Awat21/Willie_Finder/README.md

# Willie_Finder
Cat tracker using LORA

- [BOM.md](BOM.md) - parts list with links
- [case/](case/) - collar pod case model (STEP, STL, CadQuery source)
- [pcb/](pcb/) - custom single-board tracker: schematic and first-pass layout (KiCad 9)
