Awat21/Willie_Finder/pcb/renders/board_bottom.png

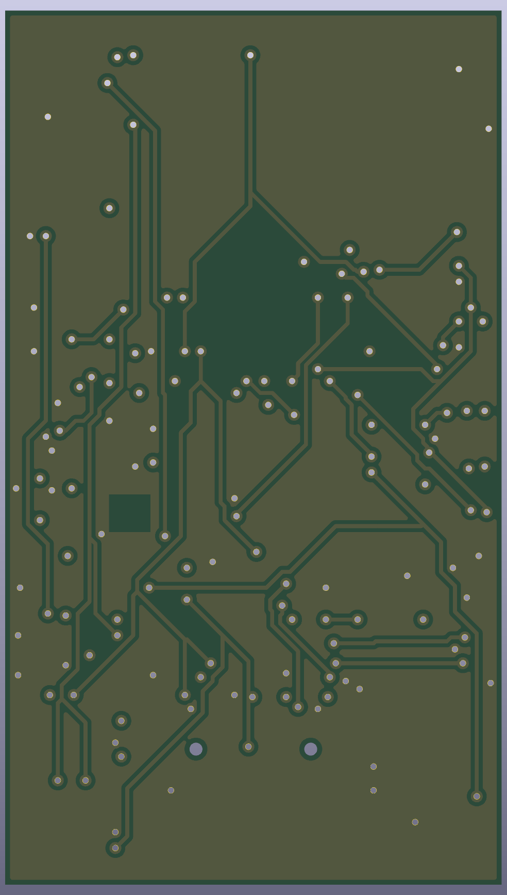
pcb/renders/board_bottom.png
