Awat21/Willie_Finder/pcb/renders/board_top.png

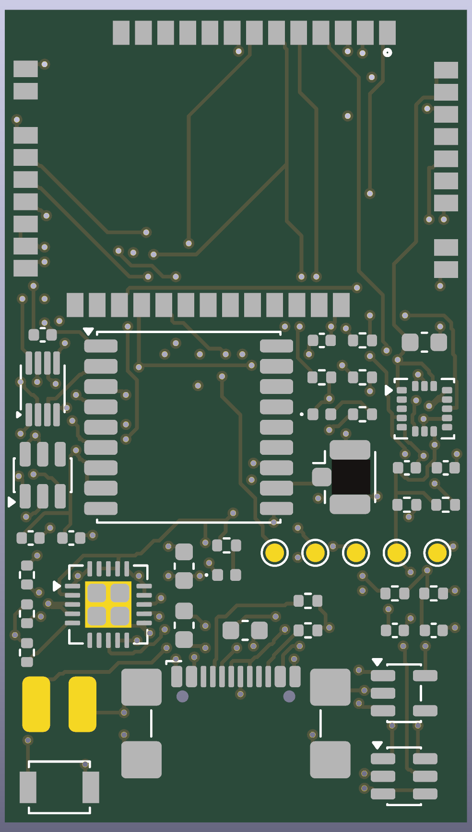
pcb/renders/board_top.png
