Awat21/Willie_Finder/case/collar_pod_case.step

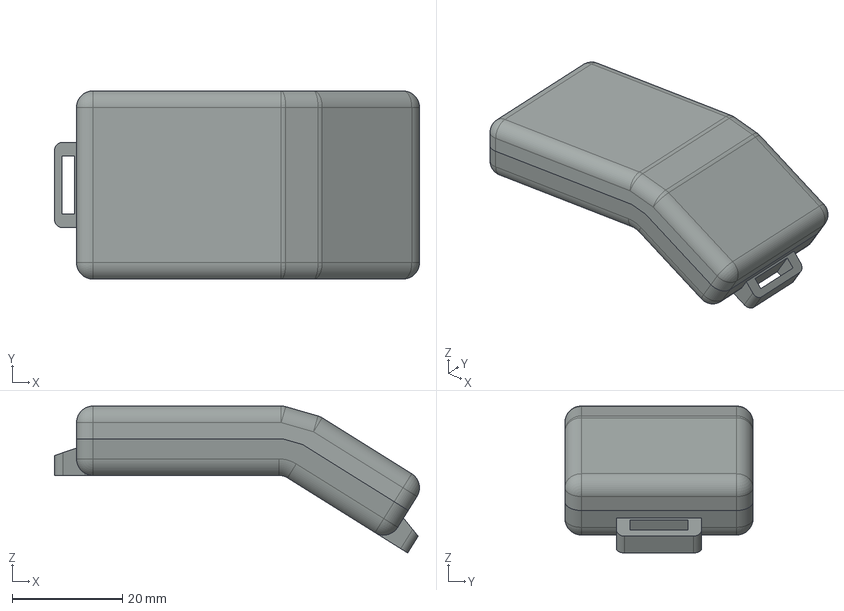
[picture p3: CAD file, 2026-11-11]
case/collar_pod_case.step
66.3 x 34.2 x 26.7 mm
base
lid
