Awat21/Willie_Finder/case/stl/base.stl

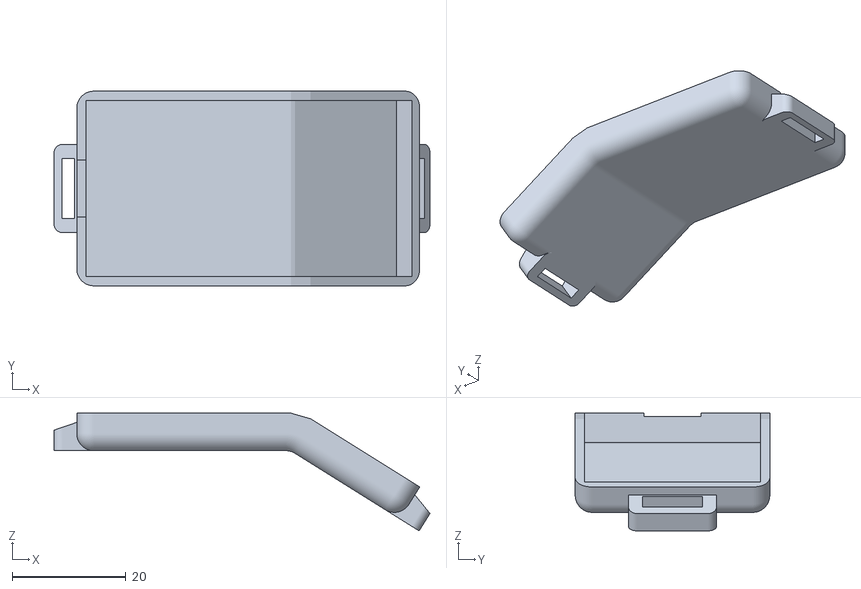
[picture p4: CAD file, 2026-11-11]
case/stl/base.stl
66.1 x 34.2 x 20.7
