Awat21/Willie_Finder/pcb/willie_tracker_board.step

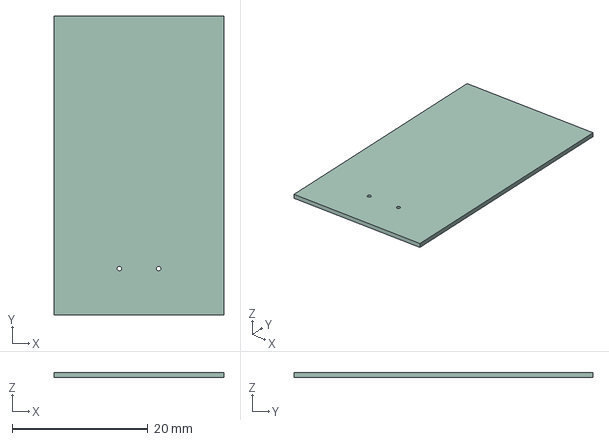
[picture p5: CAD file, 2026-11-11]
pcb/willie_tracker_board.step
25.0 x 44.0 x 0.71 mm
