Awat21/Willie_Finder/case/collar_pod.step

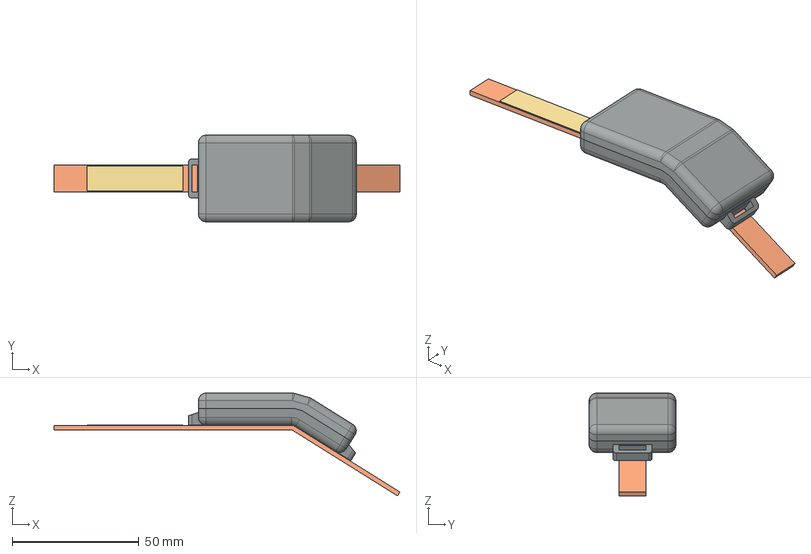
[picture p6: CAD file, 2026-11-11]
case/collar_pod.step
136.6 x 34.2 x 40.6 mm
base
lid
board
battery
gps
strap
antenna
