Awat21/Willie_Finder/case/stl/lid.stl

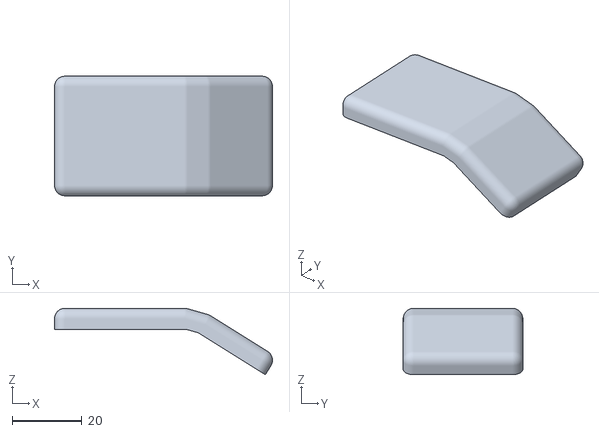
[picture p7: CAD file, 2026-11-11]
case/stl/lid.stl
62.3 x 34.2 x 19.0
