Awat21/Willie_Finder/case/stl/strap.stl

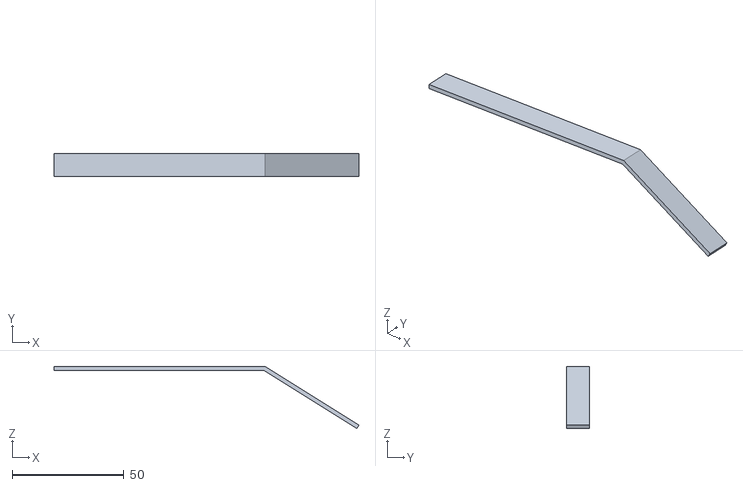
[picture p8: CAD file, 2026-11-11]
case/stl/strap.stl
136.6 x 10.5 x 27.8
