Awat21/Willie_Finder/case/stl/gps.stl

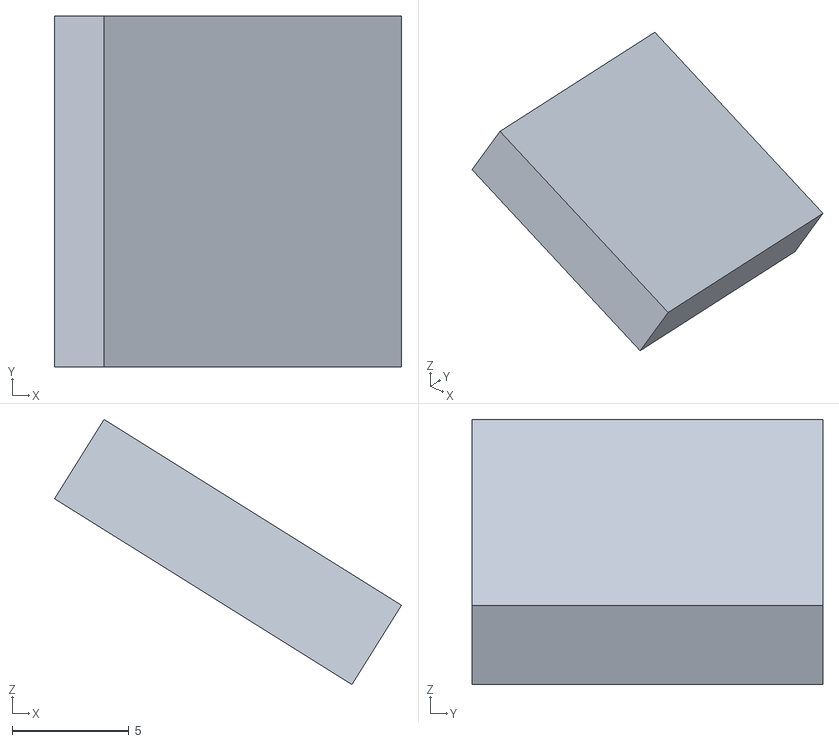
[picture p9: CAD file, 2026-11-11]
case/stl/gps.stl
14.8 x 15.0 x 11.3
