Awat21/Willie_Finder/case/stl/battery.stl

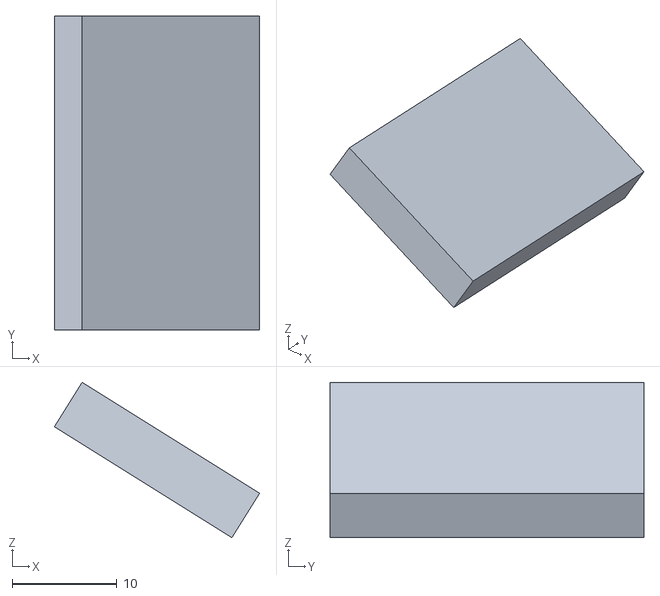
[picture p10: CAD file, 2026-11-11]
case/stl/battery.stl
19.6 x 30.0 x 14.8
