Awat21/Willie_Finder/case/stl/antenna.stl

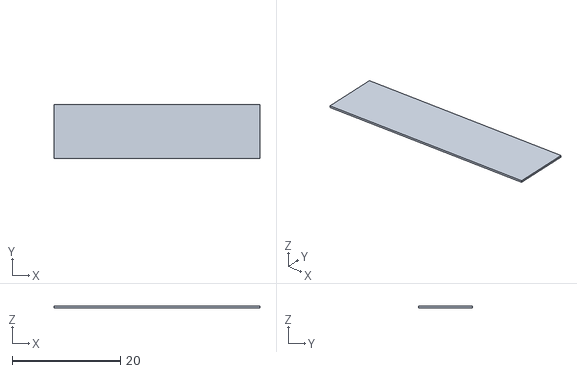
[picture p11: CAD file, 2026-11-11]
case/stl/antenna.stl
38.0 x 10.0 x 0.3
