Awat21/Willie_Finder/case/stl/board.stl

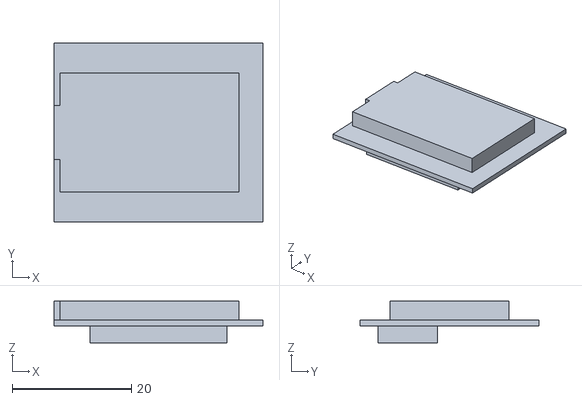
[picture p12: CAD file, 2026-11-11]
case/stl/board.stl
35.0 x 30.0 x 7.00
