Awat21/Willie_Finder/pcb/willie_tracker.pdf

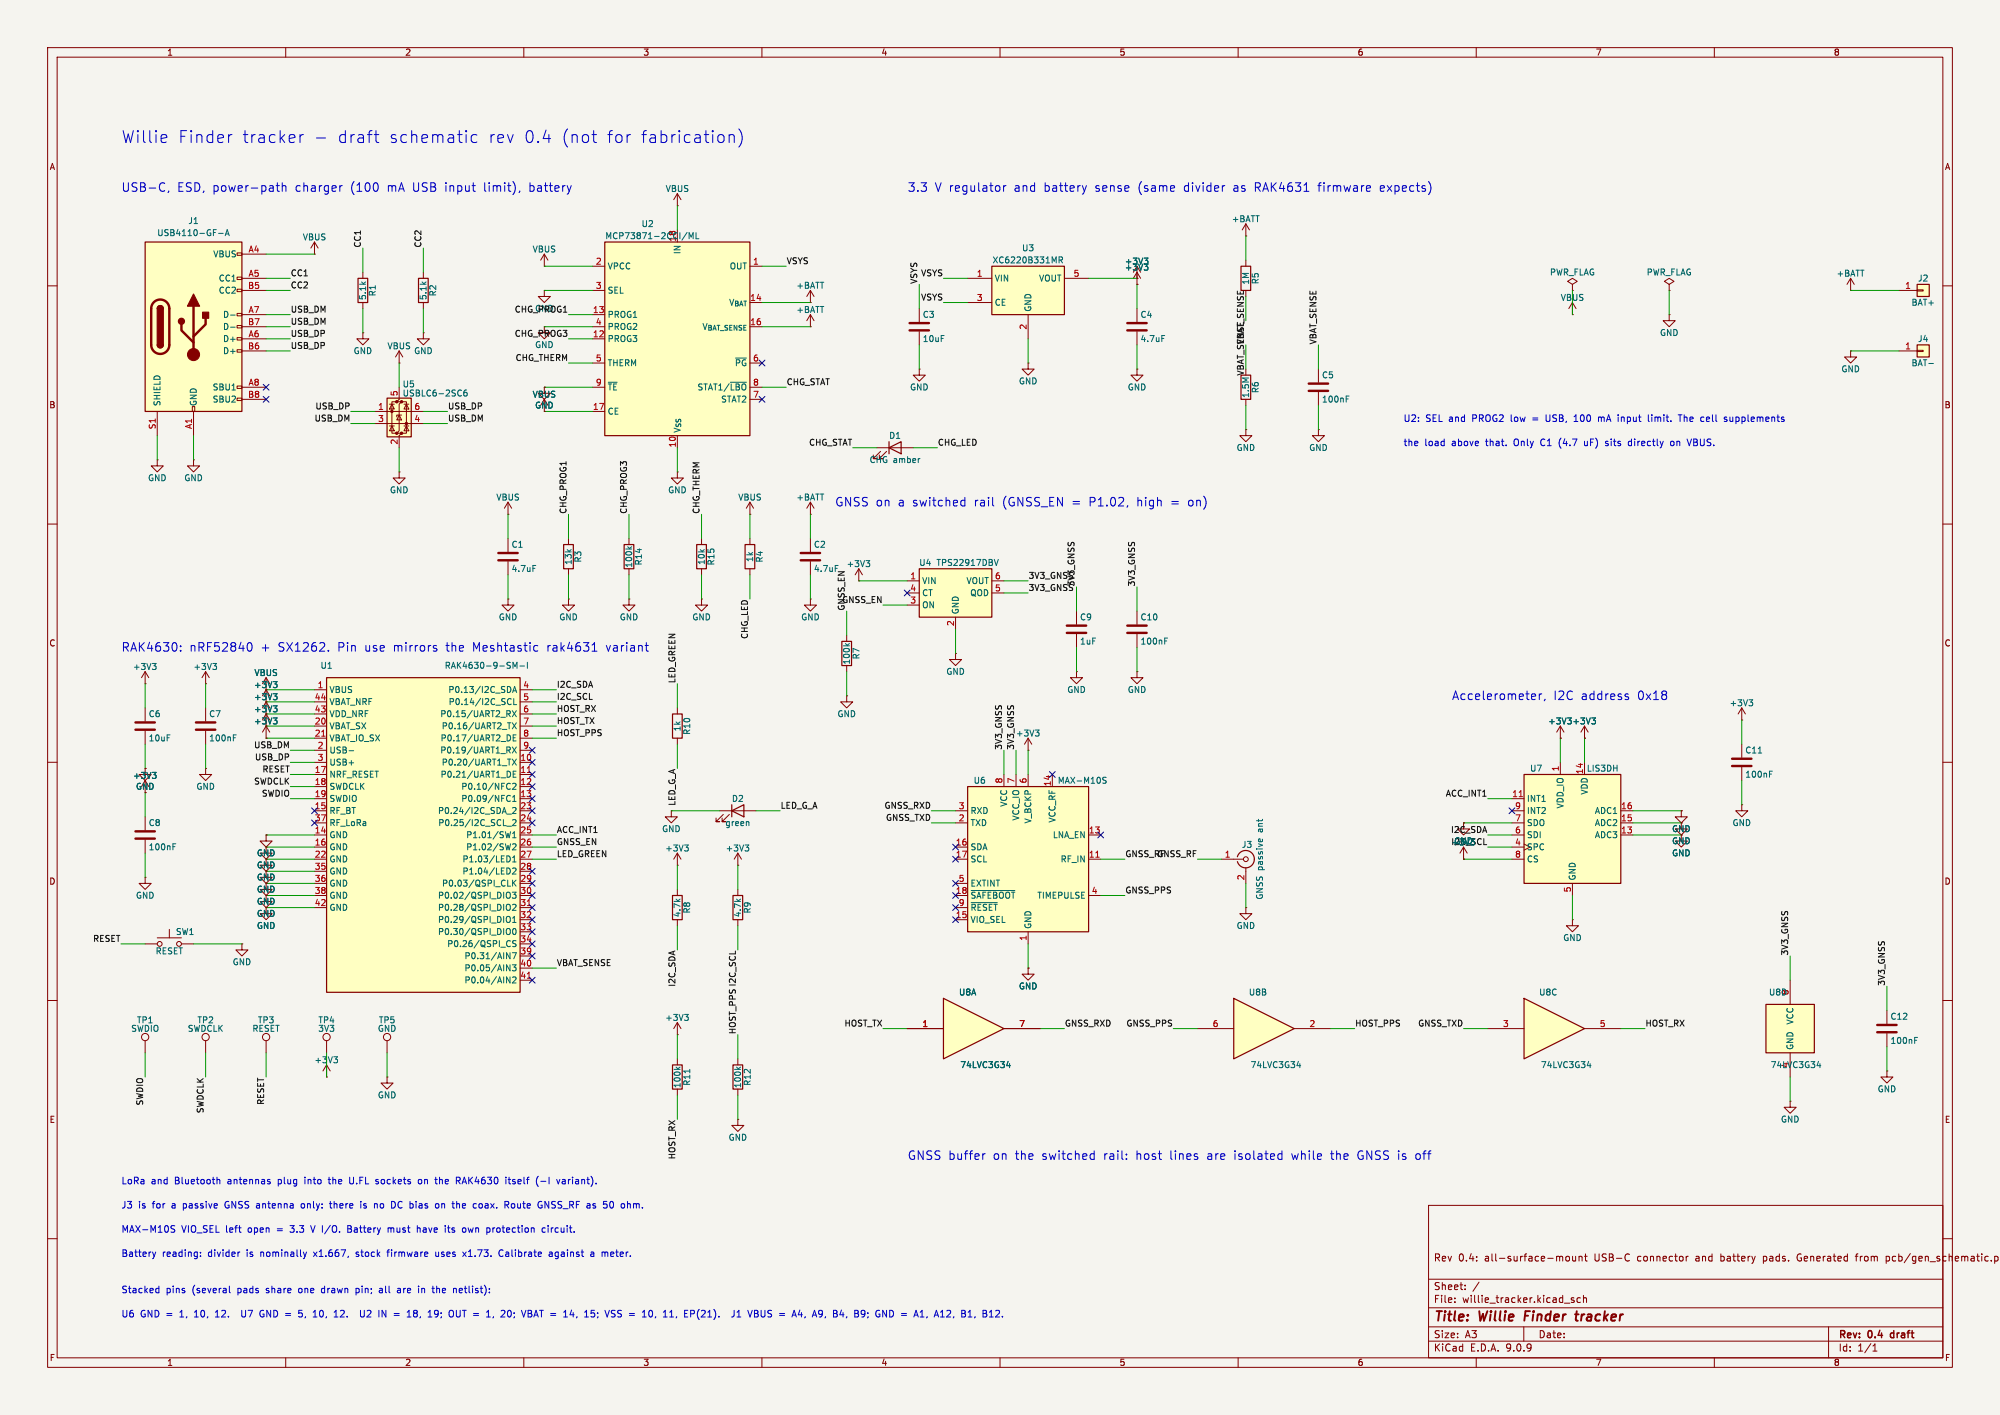
[picture p13: page 1]

I2C_SDA U2: SEL and PROG2 low = USB, 100 mA input limit. The cell supplements
