Awat21/Willie_Finder/pcb/willie_tracker.kicad_pcb

## KiCad design pcb/willie_tracker.kicad_pcb (2026-11-11)

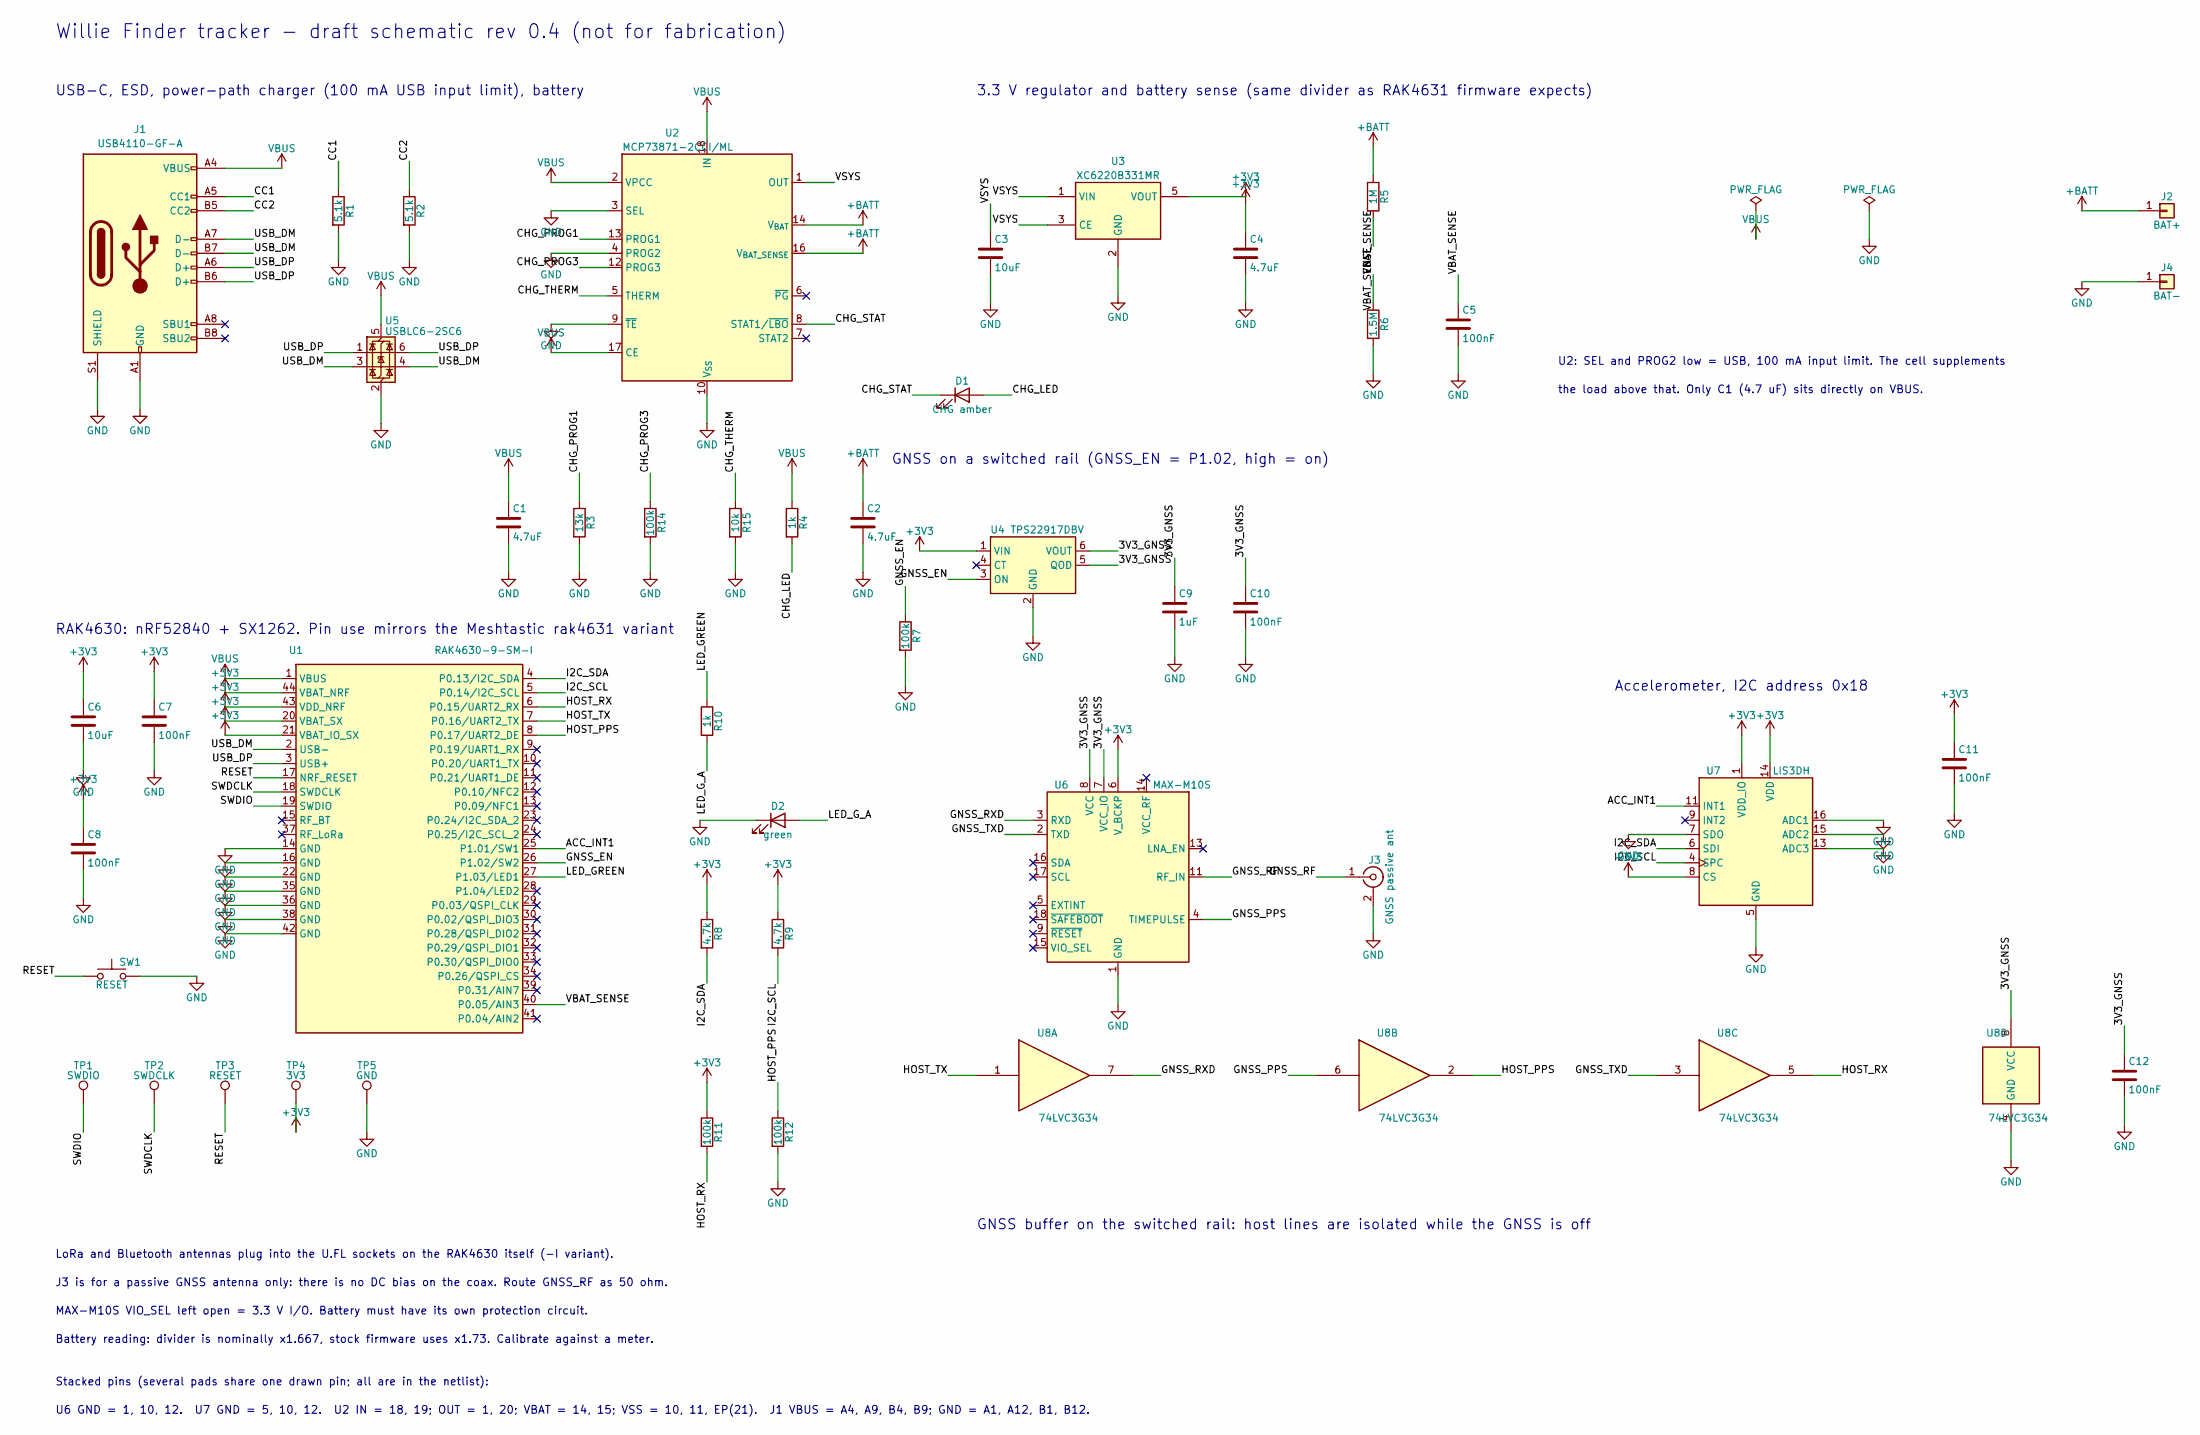
[picture p14: schematic willie_tracker.kicad_sch, Willie Finder tracker]

Parts:
C1, C2: 4.7uF; C_0603_1608Metric
C3, C6: 10uF; C_0603_1608Metric
C4: 4.7uF; C_0402_1005Metric
C5, C7, C8, C10, C11, C12: 100nF; C_0402_1005Metric
C9: 1uF; C_0402_1005Metric
D1: CHG amber; LED_0402_1005Metric
D2: green; LED_0402_1005Metric
J1: USB4110-GF-A; USB_C_Receptacle_GCT_USB4110
J2: BAT+; SolderWirePad_1x01_SMD_1.5x3mm
J3: GNSS passive ant; U.FL_Hirose_U.FL-R-SMT-1_Vertical
J4: BAT-; SolderWirePad_1x01_SMD_1.5x3mm
R1, R2: 5.1k; R_0402_1005Metric
R3: 13k; R_0402_1005Metric
R4, R10: 1k; R_0402_1005Metric
R5: 1M; R_0402_1005Metric
R6: 1.5M; R_0402_1005Metric
R7, R11, R12, R14: 100k; R_0402_1005Metric
R8, R9: 4.7k; R_0402_1005Metric
R15: 10k; R_0402_1005Metric
SW1: RESET; SW_SPST_B3U-1000P
TP1: SWDIO; TestPoint_Pad_D1.0mm
TP2: SWDCLK; TestPoint_Pad_D1.0mm
TP3: RESET; TestPoint_Pad_D1.0mm
TP4: 3V3; TestPoint_Pad_D1.0mm
TP5: GND; TestPoint_Pad_D1.0mm
U1: RAK4630-9-SM-I; RAK4630
U2: MCP73871-2CCI/ML; QFN-20-1EP_4x4mm_P0.5mm_EP2.5x2.5mm
U3: XC6220B331MR; SOT-23-5
U4: TPS22917DBV; SOT-23-6
U5: USBLC6-2SC6; SOT-23-6
U6: MAX-M10S; ublox_MAX
U7: LIS3DH; LGA-16_3x3mm_P0.5mm_LayoutBorder3x5y
U8: 74LVC3G34; VSSOP-8_2.3x2mm_P0.5mm

Connections:
+3V3: C4.1, C6.1, C7.1, C8.1, C11.1, R8.1, R9.1, R11.1, TP4.1, U1.20 (VBAT_SX), U1.21 (VBAT_IO_SX), U1.43 (VDD_NRF), U1.44 (VBAT_NRF), U3.5 (VOUT), U4.1 (VIN), U6.6 (V_BCKP), U7.1 (VDD_IO), U7.8 (CS), U7.14 (VDD)
+BATT: C2.1, J2.1, R5.1, U2.14 (V_{BAT}), U2.15 (V_{BAT}), U2.16 (V_{BAT_SENSE})
/3V3_GNSS: C9.1, C10.1, C12.1, U4.5 (QOD), U4.6 (VOUT), U6.7 (VCC_IO), U6.8 (VCC), U8.8 (VCC)
/ACC_INT1: U1.25 (P1.01/SW1), U7.11 (INT1)
/CC1: J1.A5 (CC1), R1.1
/CC2: J1.B5 (CC2), R2.1
/CHG_LED: D1.2 (A), R4.2
/CHG_PROG1: R3.1, U2.13 (PROG1)
/CHG_PROG3: R14.1, U2.12 (PROG3)
/CHG_STAT: D1.1 (K), U2.8 (STAT1/~LBO)
/CHG_THERM: R15.1, U2.5 (THERM)
/GNSS_EN: R7.1, U1.26 (P1.02/SW2), U4.3 (ON)
/GNSS_PPS: U6.4 (TIMEPULSE), U8.6
/GNSS_RF: J3.1 (In), U6.11 (RF_IN)
/GNSS_RXD: U6.3 (RXD), U8.7
/GNSS_TXD: U6.2 (TXD), U8.3
/HOST_PPS: R12.1, U1.8 (P0.17/UART2_DE), U8.2
/HOST_RX: R11.2, U1.6 (P0.15/UART2_RX), U8.5
/HOST_TX: U1.7 (P0.16/UART2_TX), U8.1
/I2C_SCL: R9.2, U1.5 (P0.14/I2C_SCL), U7.4 (SPC)
/I2C_SDA: R8.2, U1.4 (P0.13/I2C_SDA), U7.6 (SDI)
/LED_GREEN: R10.1, U1.27 (P1.03/LED1)
/LED_G_A: D2.2 (A), R10.2
/RESET: SW1.1, TP3.1, U1.17 (NRF_RESET)
/SWDCLK: TP2.1, U1.18 (SWDCLK)
/SWDIO: TP1.1, U1.19 (SWDIO)
/USB_DM: J1.A7 (D-), J1.B7 (D-), U1.2 (USB-), U5.3 (I/O2), U5.4 (I/O2)
/USB_DP: J1.A6 (D+), J1.B6 (D+), U1.3 (USB+), U5.1 (I/O1), U5.6 (I/O1)
/VBAT_SENSE: C5.1, R5.2, R6.1, U1.40 (P0.05/AIN3)
/VSYS: C3.1, U2.1 (OUT), U2.20 (OUT), U3.1 (VIN), U3.3 (CE)
GND: C1.2, C2.2, C3.2, C4.2, C5.2, C6.2, C7.2, C8.2, C9.2, C10.2, C11.2, C12.2, D2.1 (K), J1.A1 (GND), J1.A12 (GND), J1.B1 (GND), J1.B12 (GND), J1.S1 (SHIELD), J3.2 (Ext), J4.1, R1.2, R2.2, R3.2, R6.2, R7.2, R12.2, R14.2, R15.2, SW1.2, TP5.1, U1.14 (GND), U1.16 (GND), U1.22 (GND), U1.35 (GND), U1.36 (GND), U1.38 (GND), U1.42 (GND), U2.3 (SEL), U2.4 (PROG2), U2.9 (~TE), U2.10 (V_{SS}), U2.11 (V_{SS}), U2.21 (V_{SS}), U3.2 (GND), U4.2 (GND), U5.2 (GND), U6.1 (GND), U6.10 (GND), U6.12 (GND), U7.5 (GND), U7.7 (SDO), U7.10 (GND), U7.12 (GND), U7.13 (ADC3), U7.15 (ADC2), U7.16 (ADC1), U8.4 (GND)
VBUS: C1.1, J1.A4 (VBUS), J1.A9 (VBUS), J1.B4 (VBUS), J1.B9 (VBUS), R4.1, U1.1 (VBUS), U2.2 (VPCC), U2.17 (CE), U2.18 (IN), U2.19 (IN), U5.5 (VBUS)

Notes on the sheet:
Willie Finder tracker - draft schematic rev 0.4 (not for fabrication)
USB-C, ESD, power-path charger (100 mA USB input limit), battery
3.3 V regulator and battery sense (same divider as RAK4631 firmware expects)
RAK4630: nRF52840 + SX1262. Pin use mirrors the Meshtastic rak4631 variant
GNSS on a switched rail (GNSS_EN = P1.02, high = on)
Accelerometer, I2C address 0x18
GNSS buffer on the switched rail: host lines are isolated while the GNSS is off
LoRa and Bluetooth antennas plug into the U.FL sockets on the RAK4630 itself (-I variant).
J3 is for a passive GNSS antenna only: there is no DC bias on the coax. Route GNSS_RF as 50 ohm.
MAX-M10S VIO_SEL left open = 3.3 V I/O. Battery must have its own protection circuit.
Battery reading: divider is nominally x1.667, stock firmware uses x1.73. Calibrate against a meter.
Stacked pins (several pads share one drawn pin; all are in the netlist):
U6 GND = 1, 10, 12. U7 GND = 5, 10, 12. U2 IN = 18, 19; OUT = 1, 20; VBAT = 14, 15; VSS = 10, 11, EP(21). J1 VBUS = A4, A9, B4, B9; GND = A1, A12, B1, B12.
U2: SEL and PROG2 low = USB, 100 mA input limit. The cell supplements
the load above that. Only C1 (4.7 uF) sits directly on VBUS.

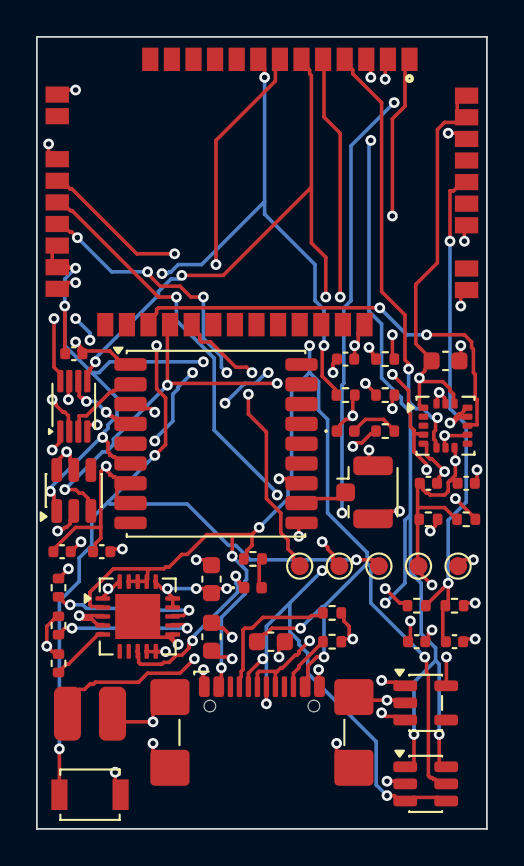
[picture p15: board willie_tracker.kicad_pcb from above]

Board: 4 copper layers, 25.0 x 44.0 mm, 46 parts (0 on the bottom side), 32 nets.
