Awat21/Willie_Finder/(commit log)

2026-11-11 Add collar pod case form-factor study
    Parametric OpenSCAD model and exported STLs for a low-profile, two-bay
    collar pod sized for the RAK WisBlock tracker parts.
    Claude-Session: https://claude.ai/code/session_015rZZoadH2C2otnBPXLuQXJ
    [base.stl, battery.stl, board.stl, collar_pod.scad, gps.stl, lid.stl, strap.stl]
2026-11-11 Show adhesive flex LoRa antenna on the collar in the case model
    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
    [antenna.stl, collar_pod.scad, strap.stl]
2026-11-11 Add BOM and STEP export of the collar pod case
    Rebuild the case in CadQuery so it exports true solid STEP files for
    editing in CAD, replacing the OpenSCAD source. Add a linked parts list.
    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
    [antenna.stl, base.stl, battery.stl, board.stl, collar_pod.scad, collar_pod.step, collar_pod_case.step, gps.stl]
2026-11-11 Add first-pass KiCad schematic for a custom tracker PCB
    Generated from a parts/net table; connectivity is checked by exporting
    the netlist with kicad-cli and comparing it to the table.
    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
    [willie_tracker.kicad_sch]
2026-11-11 Apply schematic review findings (rev 0.2)
    Add USB load sharing, use the recommended regulator capacitors, buffer
    the GNSS UART and PPS lines from the switched rail, and document the
    passive antenna and firmware checks.
    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
    [willie_tracker.kicad_sch]
2026-11-11 Schematic rev 0.3: power-path charger and verified stacked pads
    Replace the MCP73831 and discrete load sharing with an MCP73871 set to
    the 100 mA USB input limit. Export the KiCad netlist into the repo and
    assert the stacked ground and supply pads on every check run.
    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
    [willie_tracker.kicad_sch]
2026-11-11 Move schematic to KiCad 9 format and add ERC report
    Regenerate against the KiCad 9 libraries, add a project file and symbol
    library table, and run kicad-cli ERC as part of the check script.
    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
    [willie_tracker.kicad_sch]
2026-11-11 Add first-pass PCB layout for the custom tracker
    RAK4630 land pattern from RAK's datasheet drawings, scripted placement,
    and a grid autorouter with rip-up and re-route. 25.5 x 28 mm, 4 layers,
    parts on both sides. KiCad DRC: 0 violations, 0 unconnected.
    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
    [willie_tracker.kicad_pcb, willie_tracker_board.step]
2026-11-11 Rework layout as a 25 x 40 mm board with tall parts on one side
    Longer, narrower rectangle; only 0402 parts and test pads underneath,
    for an assembled thickness of about 4.5 mm. KiCad DRC clean.
    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
    [willie_tracker.kicad_pcb, willie_tracker.kicad_sch, willie_tracker_board.step]
2026-11-11 Make the board single-sided for hot-plate reflow (25 x 44 mm)
    All parts surface-mount on the top side: GCT USB4110 connector, SMD
    battery pads, test pads on top. Router reuses ground vias and adds a
    bottom ground pour and an inner 3.3 V pour. Schematic rev 0.4.
    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
    [willie_tracker.kicad_pcb, willie_tracker.kicad_sch, willie_tracker_board.step]
